abdulmomen-ghalkha/AmbientIoT/README.md

# Ambient IoT Project

A low-power, solar-powered sensor node that measures **temperature, humidity and soil moisture** and sends the readings to a smartphone over **Bluetooth Low Energy**.

```
 SHT40 / SHT31 ──I2C──┐
                      ├─► STM32 Nucleo L412KB ──UART (STX..ETX frame)──► Seeed XIAO nRF52840 ──BLE──► Phone
 Soil moisture ──ADC──┘        (sensing, STOP2 sleep)                       (UART→BLE bridge)
      ▲ GPIO power switch
                                        ▲
 Solar panel ─► BQ25570 PMU ─► Supercap ─► TPS63020 buck-boost (3.3 V) ─┘
```

The full build guide is in [AmbientIoT.pdf](AmbientIoT.pdf). This README is the team plan: where we are, what is left, and who does what.

## Repository layout

| Path | What it is |
|---|---|
| `AmbientIoT.pdf` | Course user guide (wiring, CubeMX settings, framing protocol, PMU, profiling, optimizations) |
| `IoT_test/IoT_test/` | **Current STM32CubeIDE project** (`IoT_test.ioc`, firmware in `Core/Src/main.c`) |
| `unoptimized_setup_oulu/` | Earlier STM32 project: the unoptimized baseline (HAL_Delay loop, no sleep) |
| `unoptimized_BLE_full_connection/` | Placeholder (empty). Intended for the connected-BLE Xiao sketch and its PPK2 profile |
| `optimized_BLE_burst_beaconing/` | Placeholder (empty). Intended for the burst-beacon Xiao sketch and its PPK2 profile |

## Current status

Derived from what is in the repo, so please correct it if the hardware tells a different story.

| Area | Status |
|---|---|
| STM32 sensor read (I2C + ADC), payload framing `0x02 … 0x03`, wake-ping `0xFF` | Code written. Needs hardware verification |
| STM32 STOP2 deep sleep with RTC wake-up every 30 s, all GPIOA/GPIOB to analog before sleep | Code written. Needs PPK2 verification |
| BLE firmware for the XIAO nRF52840 (Arduino) | **Not in the repo**. Nothing to build on yet |
| Phone side / data viewing | Not started (nRF Connect app is the minimum) |
| Hardware mods (SB14/SB9, LED removal, buck-boost, PMU, solar) | Unknown. Track in Phase 4 |
| Power profiling and energy budget | Not started. No measurements in the repo |
| Report / demo | Not started |

**Known issues in the STM32 code to fix** (see Phase 1):

- The code reads an **SHT31** (`0x24 0x00`, humidity = 100·raw/65535) but the guide and our parts are an **SHT40** (`0xFD`, humidity = −6 + 125·raw/65535). `main_backup.c` still has the SHT40 version. Decide which sensor is fitted and delete the other path.
- `HAL_Delay(2000)` at the top of the loop keeps the CPU awake 2 s per cycle, which is wasteful.
- `__io_putchar` is commented out, so every `printf` goes nowhere. Put debug output behind a `DEBUG` macro instead of commenting code in and out.
- No CRC check on the sensor bytes, no ADC calibration after `HAL_ADC_Init` (needed on STM32L4 after every re-init), and a 2.5-cycle ADC sample time that may be too short for the soil sensor.
- Soil moisture is sent as a raw ADC count with no dry/wet calibration.
- Setting **all** of GPIOA to analog also disables PA13/PA14 (SWD). Once asleep the board may be hard to reflash. Know the recovery procedure (hold reset while connecting, or reflash with SB14/SB9 closed).
- Dead code and leftovers: `main_backup.c`, unused `BLE_EN_Pin`, a shadowed `tx_buffer`.
- Build output (`STM32CubeIDE/Debug/*.o`, `.d`, `.su`, …) and `.DS_Store` files are committed and there is no `.gitignore`.

## Plan

Seven work areas, one owner each. Names and dates are blank on purpose: fill them in at the first meeting. Hardware is shared, so anything that needs the bench (Phases 3-5) must be booked and pairs should share a kit.

| # | Role | Owner | Main responsibility |
|---|---|---|---|
| 1 | STM32 firmware lead | | Sensing, framing, STOP2, code quality |
| 2 | BLE firmware lead | | XIAO nRF52840 sketches (connected, then burst beacon) |
| 3 | Hardware lead | | Wiring, board modifications, soldering, PMU and solar assembly |
| 4 | Power measurement lead | | PPK2 profiling, energy budget, optimization results |
| 5 | Phone / data lead | | Receiving, decoding, logging and displaying data |
| 6 | Integration and test lead | | End-to-end tests, autonomy test, bug tracking |
| 7 | Documentation and project lead | | Repo hygiene, schedule, report, final presentation |

### Phase 0: Kickoff (week 1)

- [ ] Confirm the course **deadline and deliverables** (report? demo? presentation?) and put the dates in the milestone table below.
- [ ] Fill in the owner table, agree on a meeting slot and a chat channel.
- [ ] Agree on branch and PR rules: one branch per task, PR reviewed by one other member, `main` always builds.
- [ ] Inventory the kit: how many complete kits do we have, and who holds what.
- [ ] **Owner 7:** add a `.gitignore`, untrack build artifacts and `.DS_Store`, remove `main_backup.c`, add `ble-firmware/`, `measurements/` and `docs/` folders (or use the two placeholder folders above).

### Phase 1: Baseline system on USB power (weeks 1-2)

Goal: sensor readings arrive on a phone in nRF Connect. This is the unoptimized system from guide sections III-VII.

| Task | Owner |
|---|---|
| Wire breadboard per the guide table (SHT40 on PB6/PB7, moisture VCC on PB1, data on PA4, XIAO on PA9/PA10), verify with a multimeter, common GND | 3 |
| Resolve SHT31 vs SHT40, keep only one code path | 1 |
| Verify CubeMX/`.ioc` against the guide (MSI 4 MHz, USART1/2 at 115200 8N1, I2C1 100 kHz, ADC1 ch. 9 single-ended 12-bit, RTC wake-up 1 Hz counter 30, RTC-WKUP interrupt enabled, RTC clock from LSE) | 1 |
| Add CRC-8 check on both SHT words, ADC calibration, longer ADC sample time, `DEBUG` macro for `printf` | 1 |
| Calibrate soil moisture: record raw ADC in dry air and in water, define the % mapping | 1 + 3 |
| Write the XIAO **connected** BLE UART sketch: STX/ETX state machine, ignore everything before `0x02`, send the buffered string on `0x03` | 2 |
| Verify with CoolTerm/serial monitor first, then nRF Connect. Debug in this order: sensors, STM to XIAO, XIAO to phone | 6 |

**Done when:** temperature, humidity and moisture appear in nRF Connect, values are plausible against a reference (e.g. a phone/room thermometer, a wet and dry sample), and 30 minutes of running shows no dropped frames.

### Phase 2: Unoptimized baseline measurement (week 2-3)

- [ ] Power the node from the bench supply at 3.3 V, 100 mA limit, with the PPK2 in series (Ampere Meter mode).
- [ ] Save the `.ppk` and `.csv` for the **5-second connected-BLE profile** in `unoptimized_BLE_full_connection/`. Expected: about 10 mA floor with 25-30 mA BLE spikes. **(4)**
- [ ] Commit the connected-BLE sketch next to it. **(2)**

### Phase 3: Power optimization (weeks 3-5)

Goal: reach the guide's target of about 0.6 mA floor and about 12 mA peaks with a 30 s cycle.

| Task | Owner |
|---|---|
| Remove `HAL_Delay(2000)` and other active waits, keep only the delays the sensors need (about 15 ms SHT, about 10 ms moisture settle) | 1 |
| Verify STOP2 wake-up over many cycles (RTC wake, clocks restored, peripherals re-initialised, no hang). Keep an SWD recovery path | 1 |
| Decide the final measurement interval (guide suggests minutes to hours; 30 s is the demo value) and make it one constant | 1 + 4 |
| XIAO **burst beacon** sketch: 0xFF wake interrupt, parse floats into raw bytes in Manufacturer Specific Data, advertise every 100 ms for 2 s, then stop radio and sleep | 2 |
| XIAO hardware settings: TX power -4 dBm, DC-DC enabled, all LEDs driven high (off) | 2 |
| Physically desolder the SHT40 breakout LED; check the XIAO/Nucleo power LEDs | 3 |
| Profile after each change (STOP2, then beaconing, then LED removal) so each gain is attributed. Save every run under `measurements/` | 4 |
| Confirm the phone receives the beacon reliably with a 2 s window and a cycle time that is not a multiple of the advertising interval | 6 |

**Done when:** PPK2 traces show the three phases (STOP2 floor, active sensing, BLE burst), average current is computed from the trace, and the result is committed in `optimized_BLE_burst_beaconing/`.

### Phase 4: External power and energy harvesting (weeks 4-6)

Follow guide sections IX-X in order, testing after each step. Do **not** skip the multimeter checks. Never power over USB while an external supply is connected.

| Step | Owner |
|---|---|
| Desolder SB14 and SB9 on the Nucleo, add flying wires + pin headers so the bridges can be closed for flashing. **Open = external 3.3 V, closed = USB** | 3 |
| Buck-boost (TPS63020): solder headers, keep only the 3.3 V bridge (T2) closed, test that VOUT stays 3.3 V for VIN from 5 V down to 2 V | 3 |
| Supercap charged to 4 V max (supply current limit 1 A), run the node from cap + buck-boost | 3 |
| PMU (BQ25570EVM): cap on VBAT/GND, buck-boost EN to BAT_OK, jumpers JP4 (MPPT), JP2 (/EN to GND), JP3 (VOUT_EN to VSTOR). Keep cap below 4.1 V | 3 |
| Solar panel on VIN/GND. Run the brown-out test: charge to about 3.2 V, drain under about 2.8 V (load drops), recharge to about 3 V (load restarts). If BAT_OK stalls above 3.1 V, briefly jumper VBAT to VSTOR | 3 + 6 |
| Energy budget: average current x 3.3 V, supercap runtime from `t = C x dV / I_avg` (dV about 4.1 V to 2.8 V, allow for converter efficiency), and the harvested power needed to break even in a window and under indoor light | 4 |

**Done when:** the node boots from a partly-charged supercap, browns out and recovers by itself, and the energy budget says whether a given panel and light level can sustain the chosen interval.

### Phase 5: Phone side and data (weeks 4-6, in parallel)

nRF Connect is enough for the course minimum. These tasks make the result presentable.

- [ ] Write down the **payload format** for the beacon (byte order, scaling, e.g. int16 temp x100, uint16 RH x100, uint16 moisture) and share it with Owners 1 and 2. **(5)**
- [ ] Decoder + logger (for example a Python script using `bleak` that scans, decodes and writes CSV with timestamps). **(5)**
- [ ] Simple plot or dashboard of the logged data for the demo. **(5)**
- [ ] Optional: a small phone app or web page; only if everything else is on track.

### Phase 6: Integration, long-run test, wrap-up (weeks 6-7)

- [ ] Full system on solar + supercap, run unattended for at least 24 h; log supercap voltage (multimeter or PPK2 in source mode), received packets and gaps. **(6, 3)**
- [ ] Review the "known issues" list above; every item fixed or explicitly marked as accepted. **(1)**
- [ ] Comparison table: baseline vs optimized (floor current, peak current, average current, supercap runtime). Include the PPK2 screenshots. **(4)**
- [ ] Final report and presentation/demo script. Every member writes up their own area; Owner 7 assembles and edits. **(all, 7)**
- [ ] Freeze `main`, tag the release, verify a fresh clone builds and flashes. **(7)**

## Milestones

| # | Milestone | Target date | Gate |
|---|---|---|---|
| M0 | Team organised, deadline known | | Owners and dates filled in |
| M1 | Data on phone (USB power) | | Phase 1 done |
| M2 | Baseline profile captured | | Phase 2 done |
| M3 | Optimized profile captured | | Phase 3 done |
| M4 | Runs from supercap + PMU + solar | | Phase 4 done |
| M5 | 24 h autonomous test passed | | Phase 6 test done |
| M6 | Report and demo delivered | | Course deadline |

## Risks and open questions

| Risk / question | Mitigation |
|---|---|
| Only a few kits shared by seven people | Book bench time, pair up, keep a shared wiring photo and pin table so setups can be rebuilt fast |
| Bricking access to the STM32 after aggressive GPIO isolation | Document the reflash recovery early (Phase 1) |
| Desoldering SB14/SB9 or the LED damages a board | Assign the most experienced solderer, do it once, photograph the result |
| Supercap over-voltage (above 4.1 V) damages the PMU | Always measure with a multimeter before connecting to VBAT |
| Beacon not caught by the phone in the 2 s window | Test with several phones, tune the interval and window, consider a longer burst |
| Indoor light too weak to sustain 30 s cycles | Use the energy budget to pick a longer interval (minutes) |
| Course deliverables not yet confirmed | Resolved in Phase 0 |

## How we work

- One branch per task (`firmware/remove-delay`, `ble/burst-beacon`, ...), PRs into `main`, one reviewer.
- Do not commit build output. Commit source, `.ioc`, sketches, and measurement exports (`.csv`/`.ppk`) with a one-line note on the conditions (supply, interval, firmware commit).
- After changing the pinout in CubeMX, regenerate and keep code inside the `USER CODE` blocks.
- Update the **Current status** table and tick tasks in this README as they finish, so it always reflects reality.
