abdulmomen-ghalkha/AmbientIoT/unoptimized_setup_oulu/unoptimized_setup_oulu/Core/Src/main.c

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
/* Includes ------------------------------------------------------------------*/
#include "main.h"

ADC_HandleTypeDef hadc1;

I2C_HandleTypeDef hi2c1;

UART_HandleTypeDef huart1;
UART_HandleTypeDef huart2;

/* USER CODE BEGIN PV */
//#define SHT40_ADDR (0x44 << 1) // SHT40 7-bit I2C address shifted left
//uint8_t sht40_cmd = 0xFD;      // High precision read command
//uint8_t sht40_rx[6];           // Buffer for Temp (2B) + CRC (1B) + Hum (2B) + CRC (1B)

/* USER CODE BEGIN PV */
#define SHT31_ADDR (0x44 << 1) // SHT31 7-bit I2C address shifted left
uint8_t sht31_cmd[2] = {0x24, 0x00}; // SHT31 High precision read, clock stretching disabled
uint8_t sht31_rx[6];           // Buffer for Temp (2B) + CRC (1B) + Hum (2B) + CRC (1B)

uint16_t adc_raw_val = 0;
float temperature = 0.0;
float humidity = 0.0;
char tx_buffer[100];
/* USER CODE END PV */

void SystemClock_Config(void);
static void MX_GPIO_Init(void);
static void MX_ADC1_Init(void);
static void MX_I2C1_Init(void);
static void MX_USART1_UART_Init(void);
static void MX_USART2_UART_Init(void);
/* USER CODE BEGIN 0 */
#include <stdio.h>
#include <string.h>

#define MOISTURE_VCC_Pin GPIO_PIN_1
#define MOISTURE_VCC_Port GPIOB
#define BLE_EN_Pin GPIO_PIN_4

// Redirect printf to USART2 (Debug/PC/CoolTerm)
int __io_putchar(int ch) {
    HAL_UART_Transmit(&huart2, (uint8_t *)&ch, 1, HAL_MAX_DELAY);
    return ch;
}

//void Read_Sensors(void) {
//    // Clear buffer
//    for(int i=0; i<6; i++) sht40_rx[i] = 0;
//
//    // 1. Read SHT40
//    HAL_StatusTypeDef status = HAL_I2C_Master_Transmit(&hi2c1, SHT40_ADDR, &sht40_cmd, 1, 100);
//    if (status != HAL_OK) {
//        printf("[DEBUG] I2C Transmit Error Code: %d\r\n", status);
//    }
//
//    HAL_Delay(15);
//
//    status = HAL_I2C_Master_Receive(&hi2c1, SHT40_ADDR, sht40_rx, 6, 100);
//    if (status != HAL_OK) {
//        printf("[DEBUG] I2C Receive Error Code: %d\r\n", status);
//    } else {
//        // Print raw hex data to the console
//        printf("[DEBUG] Raw Bytes: %02X %02X %02X %02X %02X %02X\r\n",
//               sht40_rx[0], sht40_rx[1], sht40_rx[2], sht40_rx[3], sht40_rx[4], sht40_rx[5]);
//    }
//
//    // Convert Raw SHT40 Data
//    uint16_t t_ticks = (sht40_rx[0] << 8) | sht40_rx[1];
//    uint16_t rh_ticks = (sht40_rx[3] << 8) | sht40_rx[4];
//    temperature = -45.0f + 175.0f * ((float)t_ticks / 65535.0f);
//    humidity = -6.0f + 125.0f * ((float)rh_ticks / 65535.0f);
//
//    // 2. Power up & Read Analog Soil Moisture
//    // Power up the sensor using the correct Port (GPIOB)
//    HAL_GPIO_WritePin(MOISTURE_VCC_Port, MOISTURE_VCC_Pin, GPIO_PIN_SET);
//    HAL_Delay(10); // Allow sensor voltage to stabilize
//
//    HAL_ADC_Start(&hadc1);
//    if (HAL_ADC_PollForConversion(&hadc1, 10) == HAL_OK) {
//        adc_raw_val = HAL_ADC_GetValue(&hadc1);
//    }
//    HAL_ADC_Stop(&hadc1);
//
//    HAL_GPIO_WritePin(GPIOA, MOISTURE_VCC_Pin, GPIO_PIN_RESET); // Power down sensor to prevent electrolysis
//}

void Read_Sensors(void) {
    // Clear buffer
    for(int i=0; i<6; i++) sht31_rx[i] = 0;

    // 1. Read SHT31 (Note the size changed to 2 bytes)
    HAL_StatusTypeDef status = HAL_I2C_Master_Transmit(&hi2c1, SHT31_ADDR, sht31_cmd, 2, 100);
    if (status != HAL_OK) {
        printf("[DEBUG] I2C Transmit Error Code: %d\r\n", status);
    }

    HAL_Delay(15); // SHT31 high repeatability takes up to ~15ms

    status = HAL_I2C_Master_Receive(&hi2c1, SHT31_ADDR, sht31_rx, 6, 100);
    if (status != HAL_OK) {
        printf("[DEBUG] I2C Receive Error Code: %d\r\n", status);
    } else {
        // Print raw hex data to the console
        printf("[DEBUG] Raw Bytes: %02X %02X %02X %02X %02X %02X\r\n",
               sht31_rx[0], sht31_rx[1], sht31_rx[2], sht31_rx[3], sht31_rx[4], sht31_rx[5]);
    }

    // Convert Raw SHT31 Data (The formula is identical to the SHT40)
    uint16_t t_ticks = (sht31_rx[0] << 8) | sht31_rx[1];
    uint16_t rh_ticks = (sht31_rx[3] << 8) | sht31_rx[4];
    temperature = -45.0f + 175.0f * ((float)t_ticks / 65535.0f);
    humidity = 100.0f * ((float)rh_ticks / 65535.0f); // Note: SHT31 humidity math is slightly different from SHT40

    // 2. Power up & Read Analog Soil Moisture
    // ... (Keep the rest of your moisture sensor code exactly the same)
    HAL_GPIO_WritePin(MOISTURE_VCC_Port, MOISTURE_VCC_Pin, GPIO_PIN_SET);
    HAL_Delay(10);

    HAL_ADC_Start(&hadc1);
    if (HAL_ADC_PollForConversion(&hadc1, 10) == HAL_OK) {
        adc_raw_val = HAL_ADC_GetValue(&hadc1);
    }
    HAL_ADC_Stop(&hadc1);

    HAL_GPIO_WritePin(GPIOA, MOISTURE_VCC_Pin, GPIO_PIN_RESET);
}

void Transmit_Data(void) {
    // 1. Prepare payload
    char tx_buffer[32];
    int len = sprintf(tx_buffer, "%.1f,%.1f,%d", temperature, humidity, adc_raw_val);

    // 2. Wrap in Envelope
    uint8_t stx = 0x02; // Start of Text
    uint8_t etx = 0x03; // End of Text

    // 3. Send
    // Disable interrupts to ensure the UART transmission is not
    // interrupted by other system tasks during the critical send window
    __disable_irq();

    HAL_UART_Transmit(&huart1, &stx, 1, 100);
    HAL_UART_Transmit(&huart1, (uint8_t*)tx_buffer, len, 100);
    HAL_UART_Transmit(&huart1, &etx, 1, 100);

    __enable_irq();
}
/* USER CODE END 0 */

/**
  * @brief  The application entry point.
  * @retval int
  */
int main(void)
{

  /* MCU Configuration--------------------------------------------------------*/

  /* Reset of all peripherals, Initializes the Flash interface and the Systick. */
  HAL_Init();

  /* Configure the system clock */
  SystemClock_Config();

  /* Initialize all configured peripherals */
  MX_GPIO_Init();
  MX_ADC1_Init();
  MX_I2C1_Init();
  MX_USART1_UART_Init();
  MX_USART2_UART_Init();
  /* Infinite loop */
  /* USER CODE BEGIN WHILE */
  printf("\r\n=== System Booted successfully ===\r\n");

    while (1)
    {
        printf("[System] Starting sensor read step...\r\n");

        // 1. Read SHT40 and Moisture Sensor
        Read_Sensors();
        if (temperature == 0.0 && humidity == 0.0) {
            printf("[DEBUG] Sensor returned zero. Check I2C Wiring!\r\n");
        }

        printf("[System] Data read: T:%.1f, H:%.1f, S:%d\r\n", temperature, humidity, adc_raw_val);
        printf("[System] Transmitting via UART1 to BLE...\r\n");

        // HAL_Delay(2000);

        // 2. Transmit to Xiao BLE via USART1
        Transmit_Data();
        //
        // HAL_Delay(2000);
        //
        // printf("[System] Transmission complete. Sleeping for 5s...\r\n");

        HAL_Delay(5000);
    /* USER CODE END WHILE */

    /* USER CODE BEGIN 3 */
  }
  /* USER CODE END 3 */
}

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
