abdulmomen-ghalkha/AmbientIoT/unoptimized_setup_oulu/unoptimized_setup_oulu/unoptimized_setup_oulu.ioc

Mcu.UserName=STM32L412KBUx
PA0-CK_IN.Signal=RCC_CK_IN
PA10.Signal=USART1_RX
PA2.Signal=USART2_TX
PA3.Signal=USART2_RX
PA4.Signal=ADCx_IN9
PA9.Signal=USART1_TX
PB1.Signal=GPIO_Output
PB6.Signal=I2C1_SCL
PB7.Signal=I2C1_SDA
